jtrelawney/Seifenkiste_0/docu/images/car_full_1.jpg

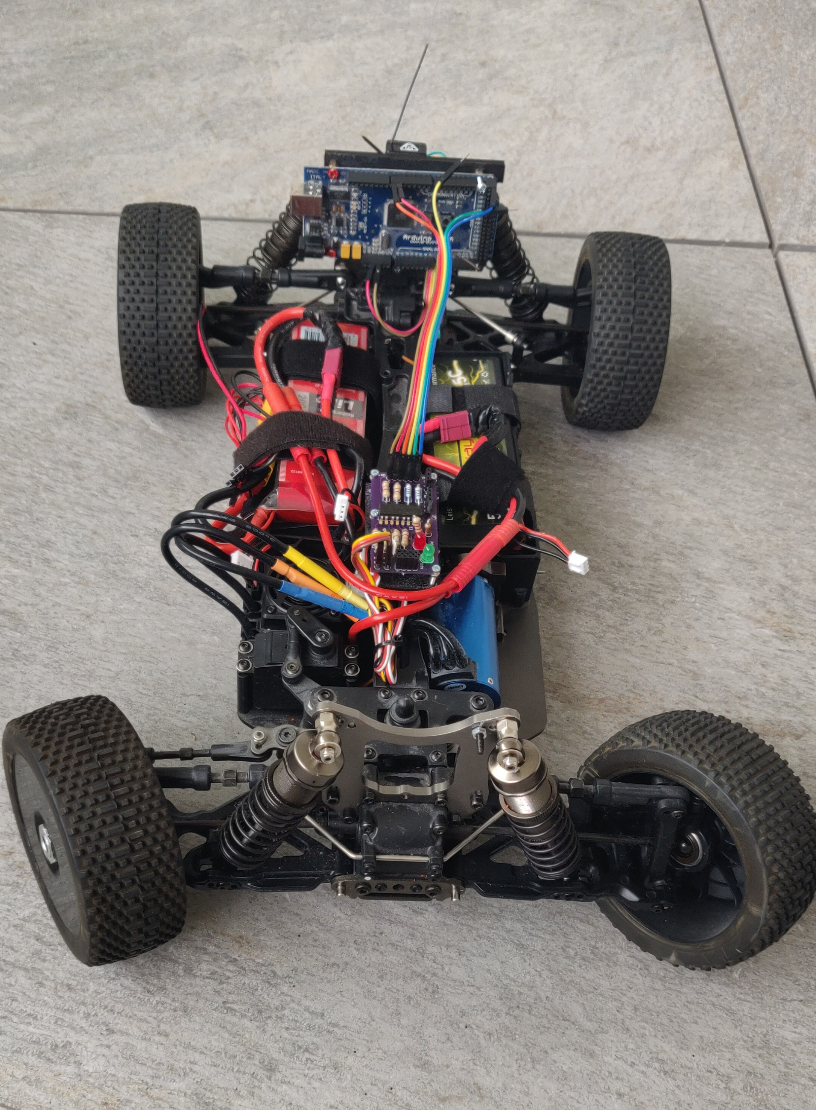
docu/images/car_full_1.jpg
