jtrelawney/Seifenkiste_0/docu/images/receiver_1.jpg

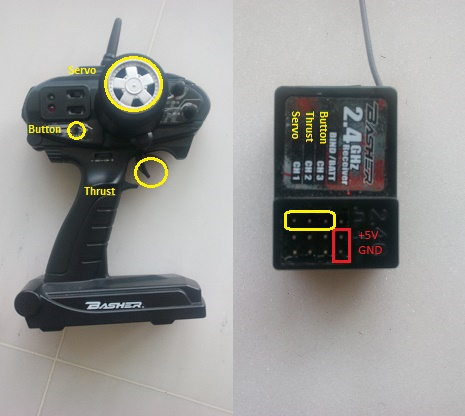
docu/images/receiver_1.jpg
