jtrelawney/Seifenkiste_0/README.md

# Seifenkiste_0
Hack the controller of a remote controlled car

V1 - read RC and set PWM
1. Port K interrupts read RC throttle and steering
2. the signals are scaled
3. the pwm output is set
