jtrelawney/Seifenkiste_0/controller_board/Receiver.odt

# Receiver

## Throttle

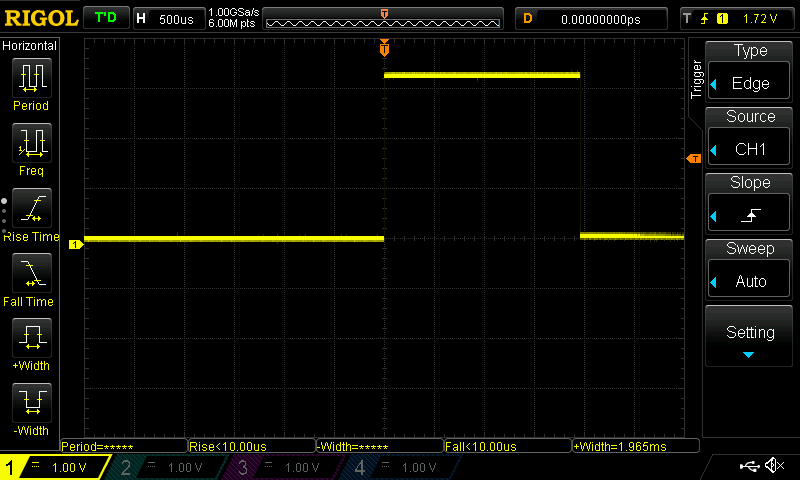
[picture p3: figure]
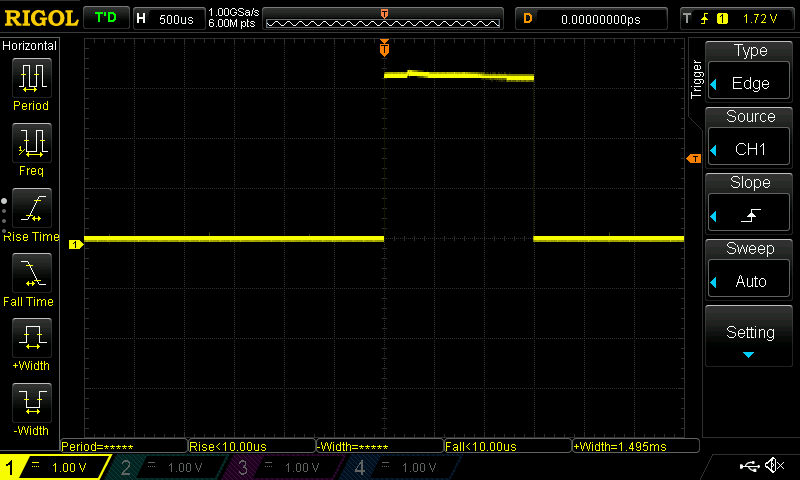
[picture p4: figure]
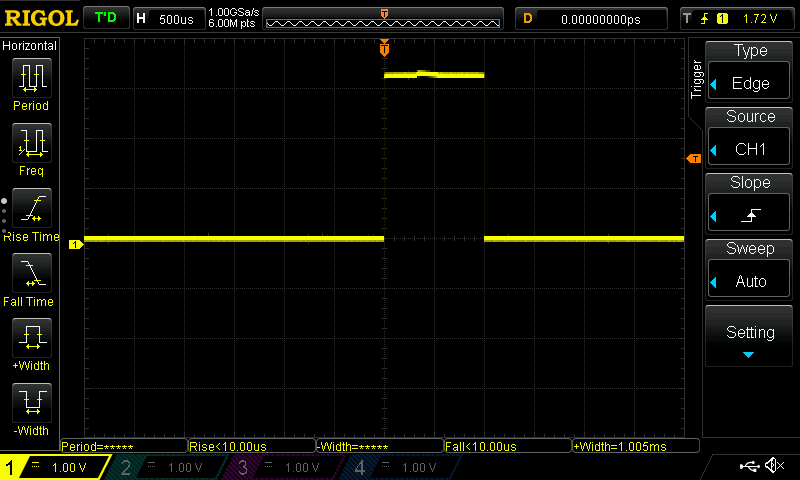
[picture p5: figure]

## Steering

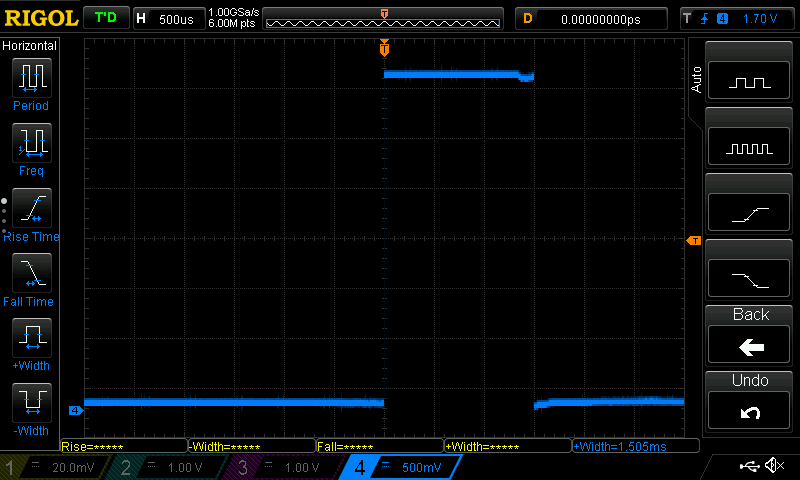
[picture p6: figure]
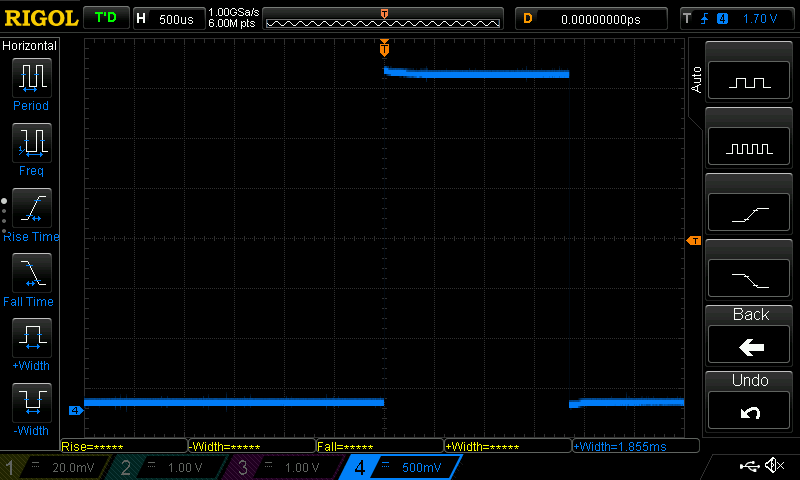
[picture p7: figure]
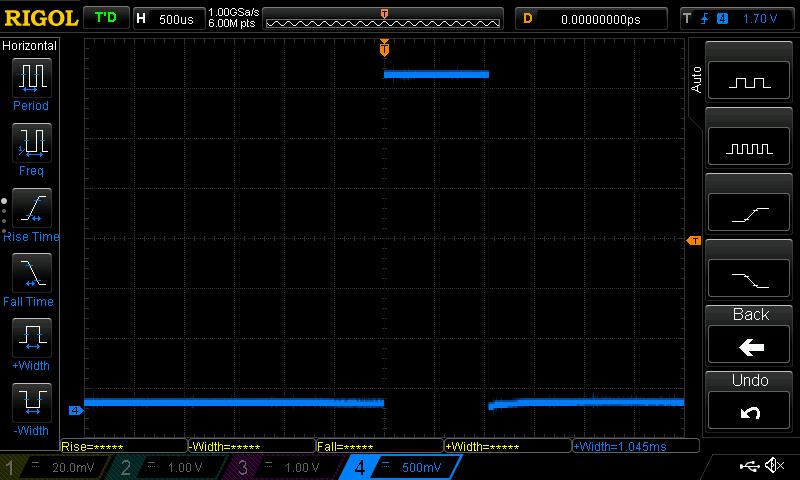
[picture p8: figure]

## Start button

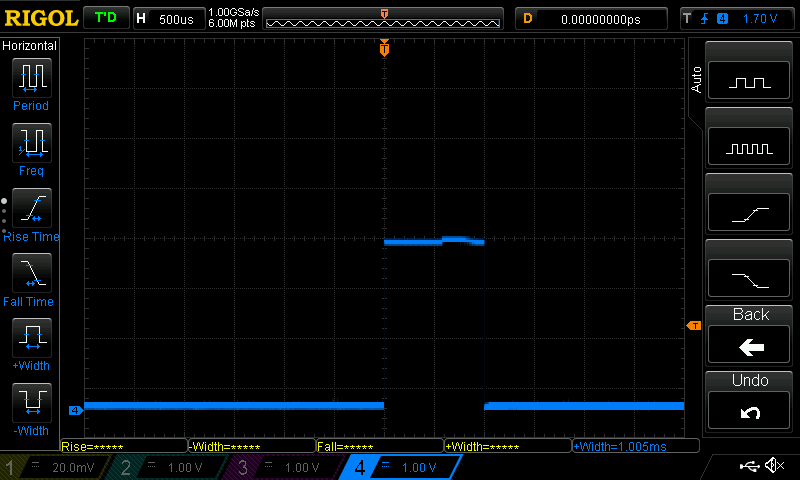
[picture p9: figure]
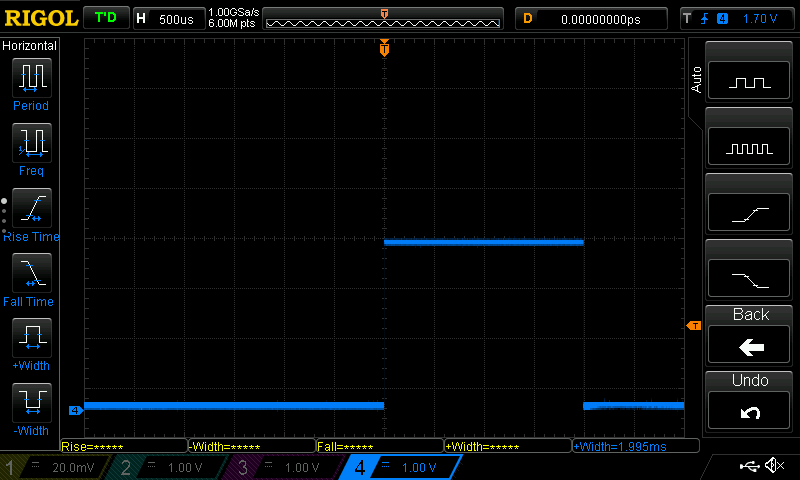
[picture p10: figure]
