jtrelawney/Seifenkiste_0/docu/ESC_programming.odt

To program the ESC : page 7-9 manual:

In general:

The green LED signals the item number, ie. if it flashes once this is the “running mode” entry.

The red LED signals the current items value, ie. if it flashes once this is “Forward with break”

Settings can be selected by releasing and pressing the SET button as described below

1. turn off ESC
2. turn on transmitter
3. hold set key and keep it pressed
4. switch on ESC

Keep holding down the SET button!

The Red LED flashes 8 or 9 times and the ESC enters the programmable mode.

Next the green LED flashes once.

This indicates that currently item number 1 “running mode” is selected.

To program item 1 release the SET key.

To program one of the next items keep the SET button pressed until the ESC has increased the item number and the green LED has flashed the corresponding number of times.

Once the item number is selected by releasing the SET button, the red LED indicates the items’s current value by flashing the corresponding number of times.

With short breaks the ESC will continue to indicate the currently selected items value.

To keep the current value switch off the ESC.

To increase the item’s value give the SET button a short push.

The ESC will now indicate the new value by flashing accordingly.

End the programming by switching off the ESC.

To calibrate the ESC with the RC signal range : page 6 manual:

1. turn off ESC
2. turn on RC with throttle in REV
3. press the SET key and turn on the ESC
4. as soon as the red light flashes release the SET key, the red light keeps flashing
5. the RC should be on neutral, i.e. the controller software should output 1.5ms
6. then press the SET key, there is one green light signal
7. the RC should now output the max forward signal, I.e the controller output needs to be 2ms.
8. Then press the SET key again, there are 2 green light signals
9. the RC should now output the max backward signal, I.e the controller output should be 1ms
10. press the SET key one last time, there are 3 green light signals.
11. Then turn of the ESC and wait 3s before turning on

The ESC is now calibrated to the range of the RC, or here to the range of the controller between 1ms and 2ms
