jtrelawney/Seifenkiste_0/controller_board/transmitter_battery/transmitter_battery.odt

Remote control battery

8 batteries which take in 2shifts of 4 take a full day to charge.

Use an LM317 together with a lipo battery to increase the time until recharge and allow for a faster charging process.

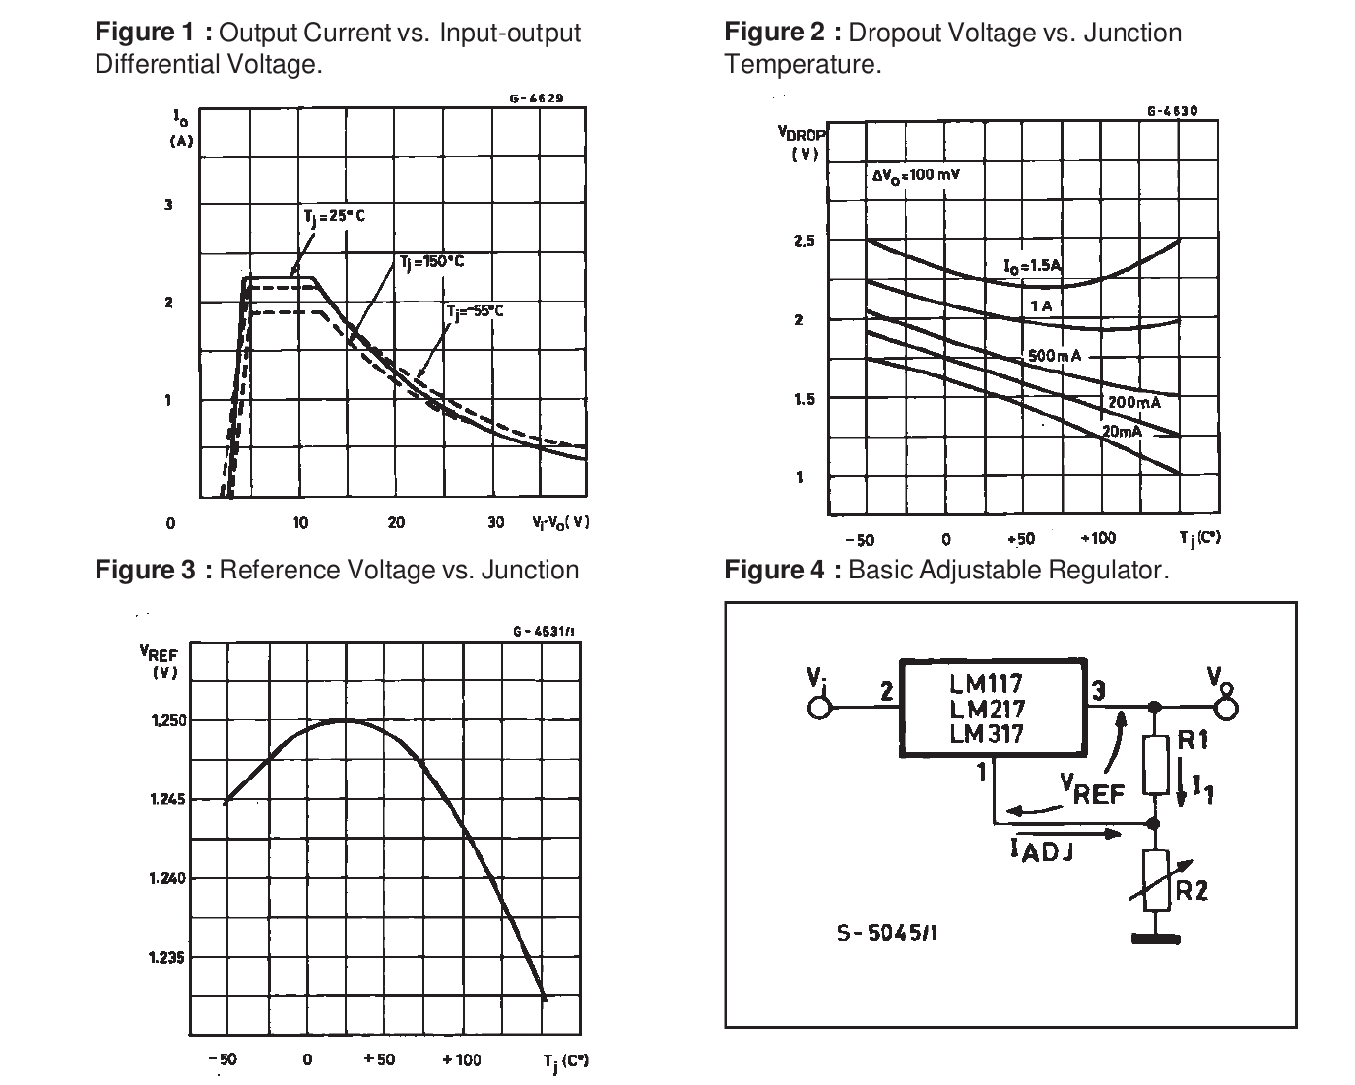
[picture p11: figure]
