jtrelawney/Seifenkiste_0/car_basher_truggy/ESC programming/programmable_settings.pdf

## BASHER SABERTOOTH MANUAL

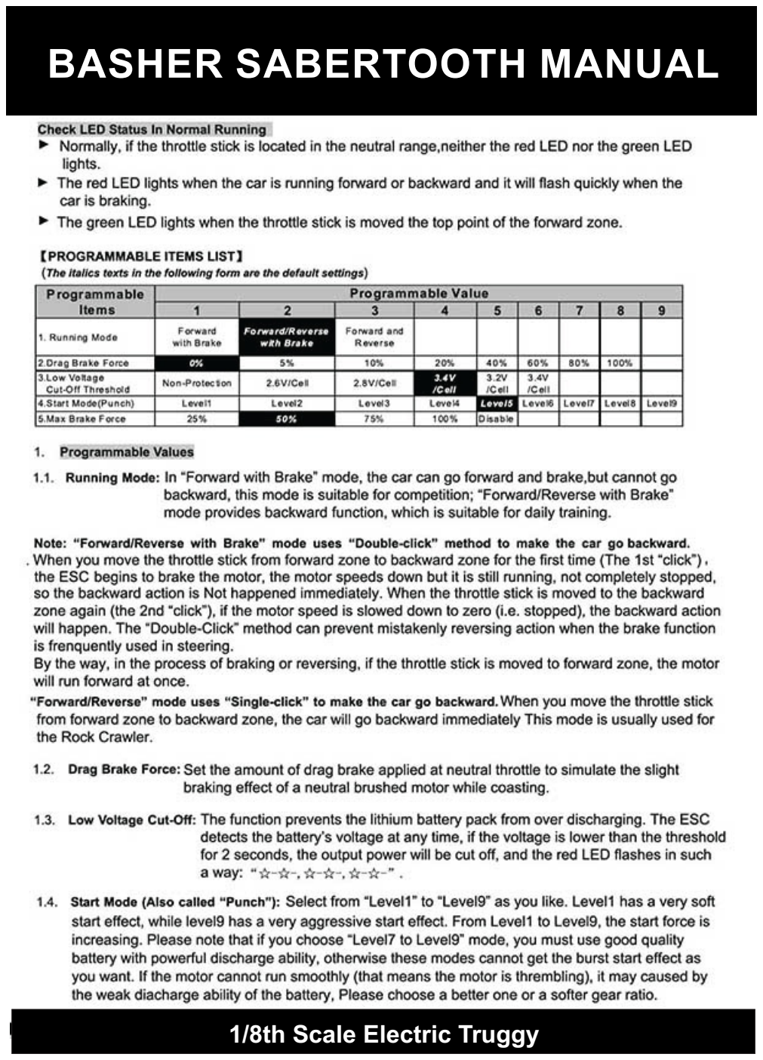
[picture p12: page 1]

1/8th Scale Electric Truggy
