jtrelawney/Seifenkiste_0/car_basher_truggy/3d_models/back_panel_2.png

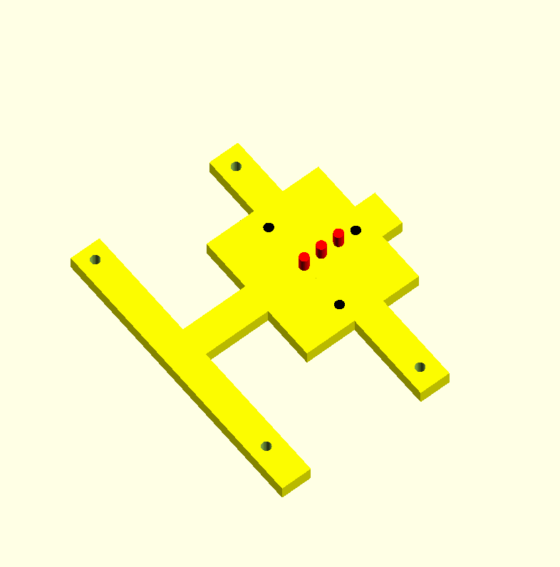
car_basher_truggy/3d_models/back_panel_2.png
