jtrelawney/Seifenkiste_0/car_basher_truggy/3d_models/controler_bed_1.png

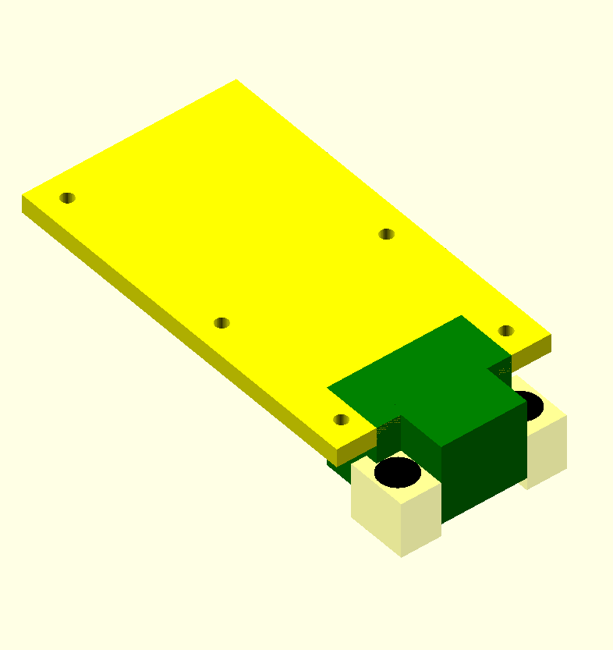
car_basher_truggy/3d_models/controler_bed_1.png
