jtrelawney/Seifenkiste_0/car_basher_truggy/ESC programming/programmable_settings_notes.jpg

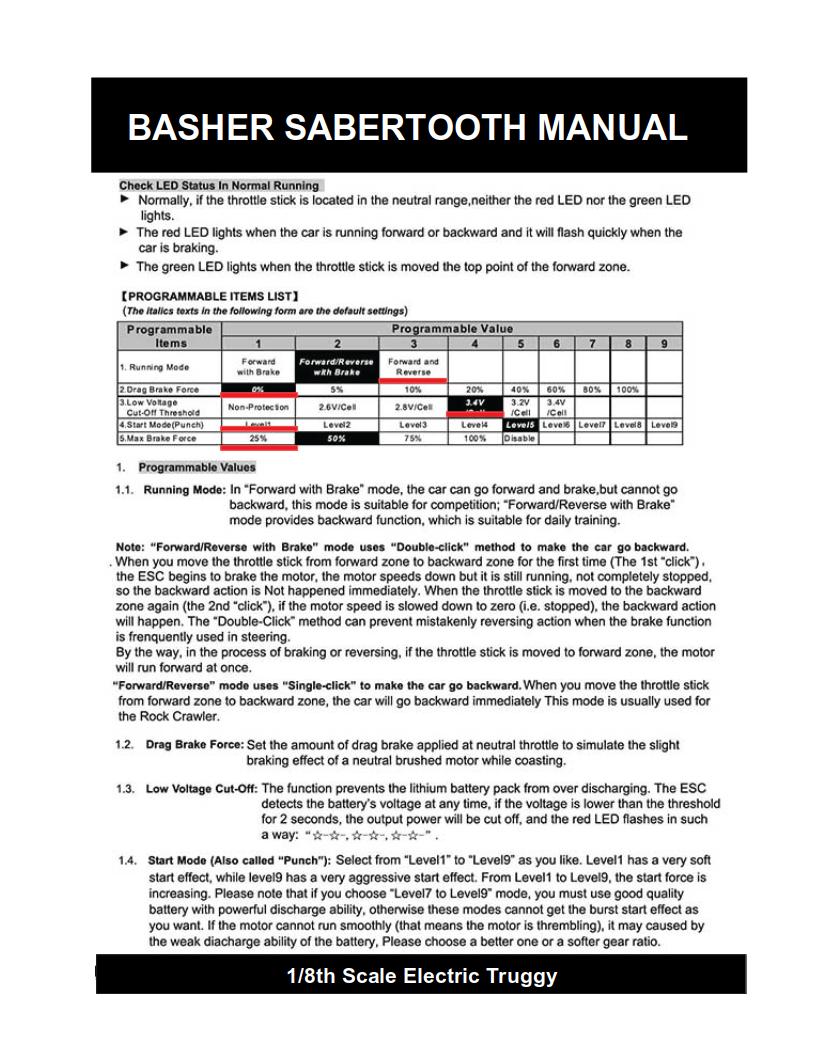
car_basher_truggy/ESC programming/programmable_settings_notes.jpg
