jtrelawney/Seifenkiste_0/controller_board/transmitter_battery/lm317_diodes.png

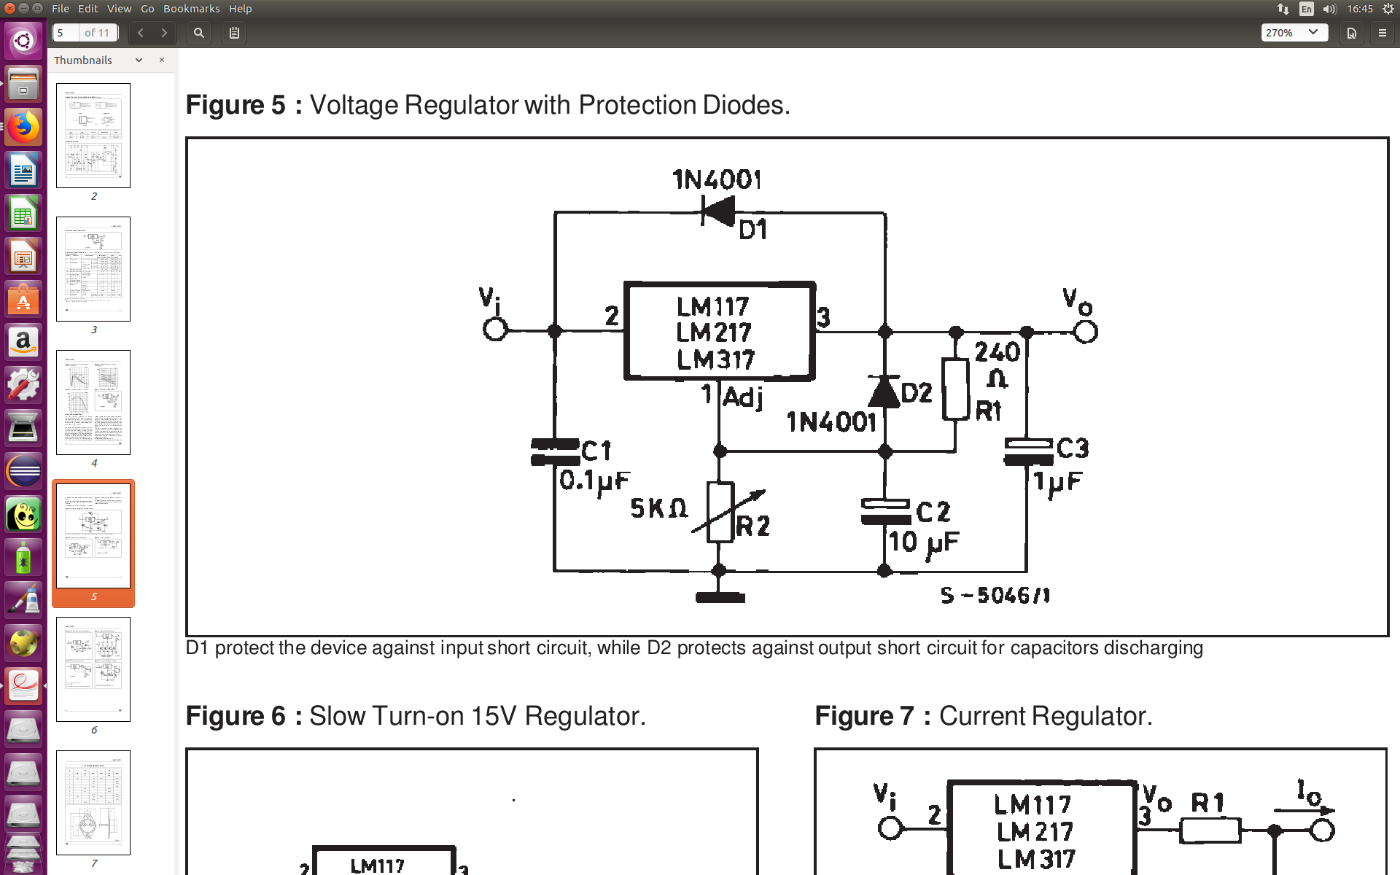
controller_board/transmitter_battery/lm317_diodes.png
