jtrelawney/Seifenkiste_0/docu/images/base_1500_4.png

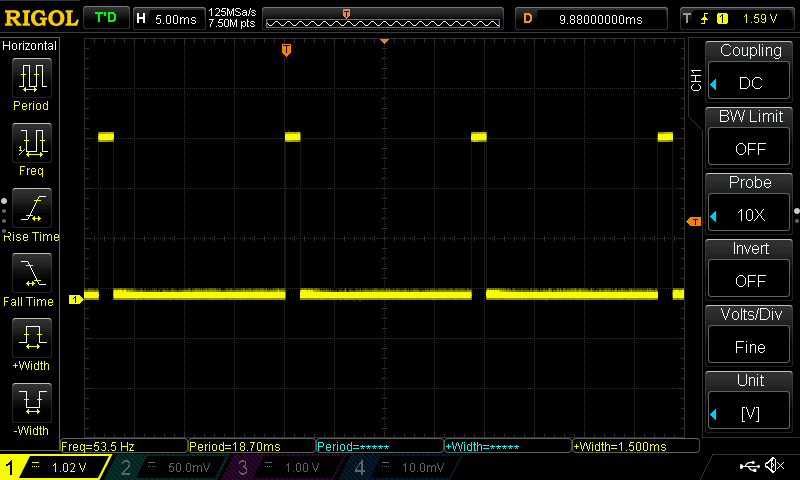
docu/images/base_1500_4.png
