jtrelawney/Seifenkiste_0/docu/images/differential_gearbox.jpg

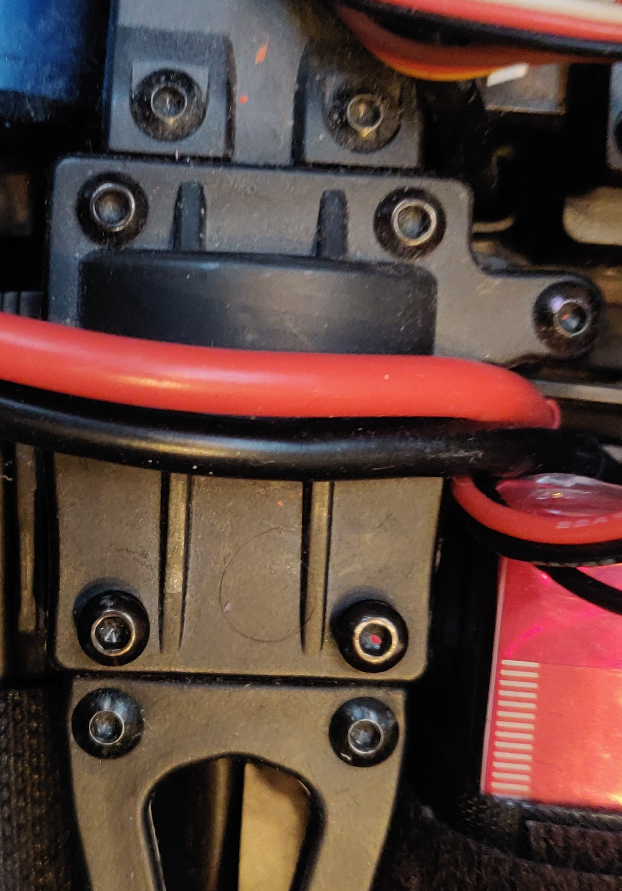
docu/images/differential_gearbox.jpg
