jtrelawney/Seifenkiste_0/docu/images/differential_gearbox_orig.jpg

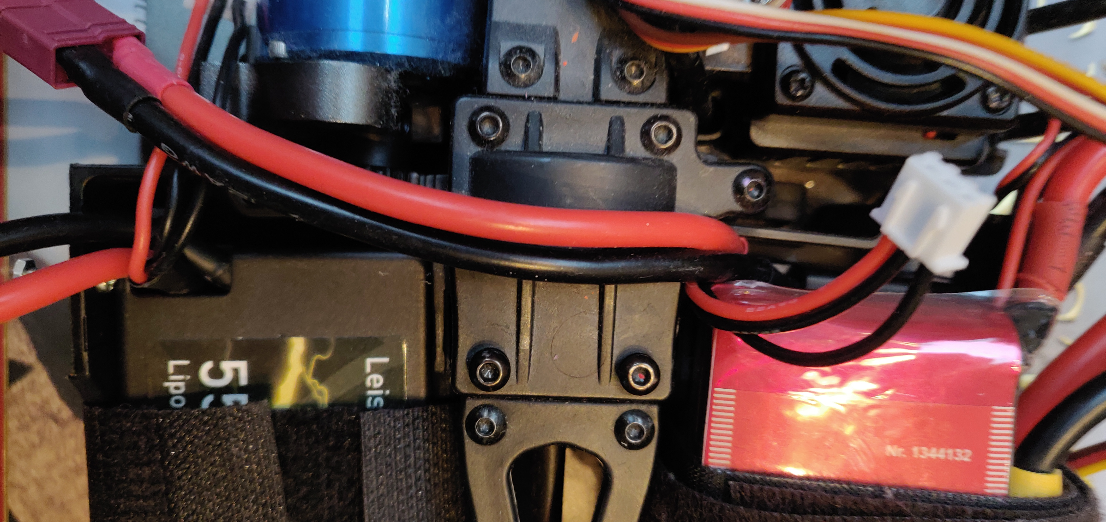
docu/images/differential_gearbox_orig.jpg
