jtrelawney/Seifenkiste_0/docu/images/lipo_remote.jpg

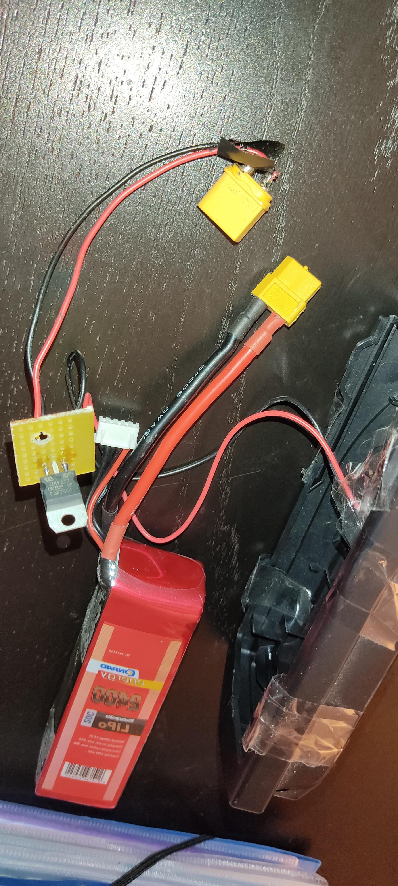
docu/images/lipo_remote.jpg
