jtrelawney/Seifenkiste_0/docu/images/max_1850_1.png

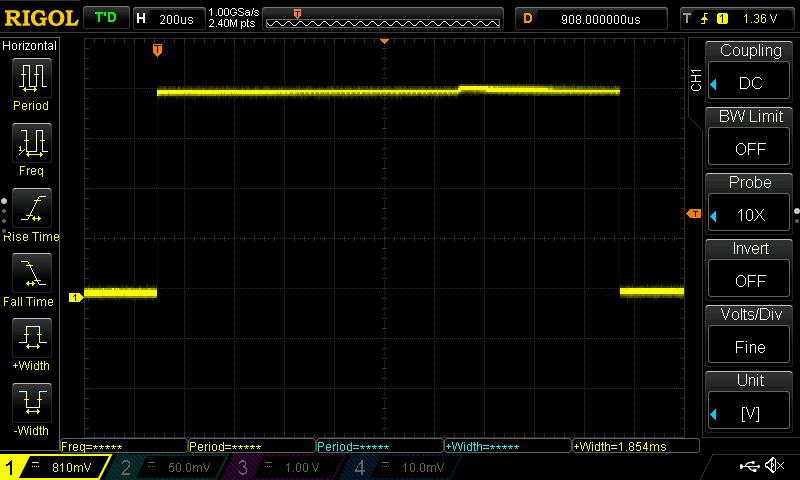
docu/images/max_1850_1.png
