jtrelawney/Seifenkiste_0/docu/images/min_1200_1.png

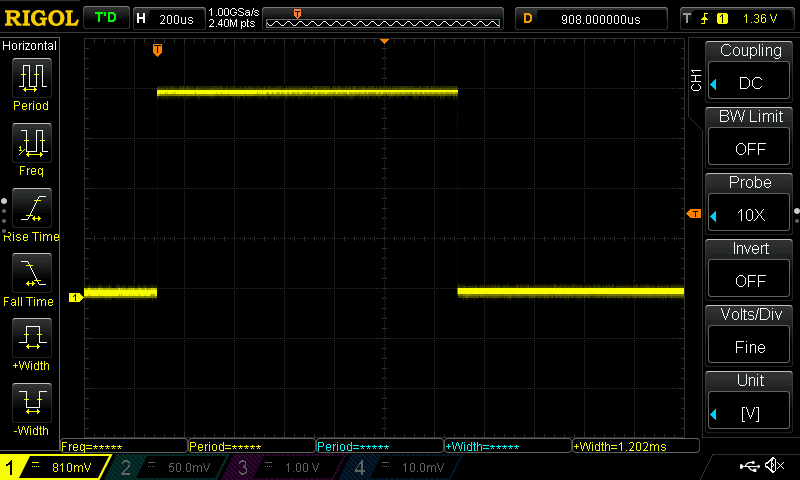
docu/images/min_1200_1.png
