jtrelawney/Seifenkiste_0/docu/images/motor_controller_processed.jpg

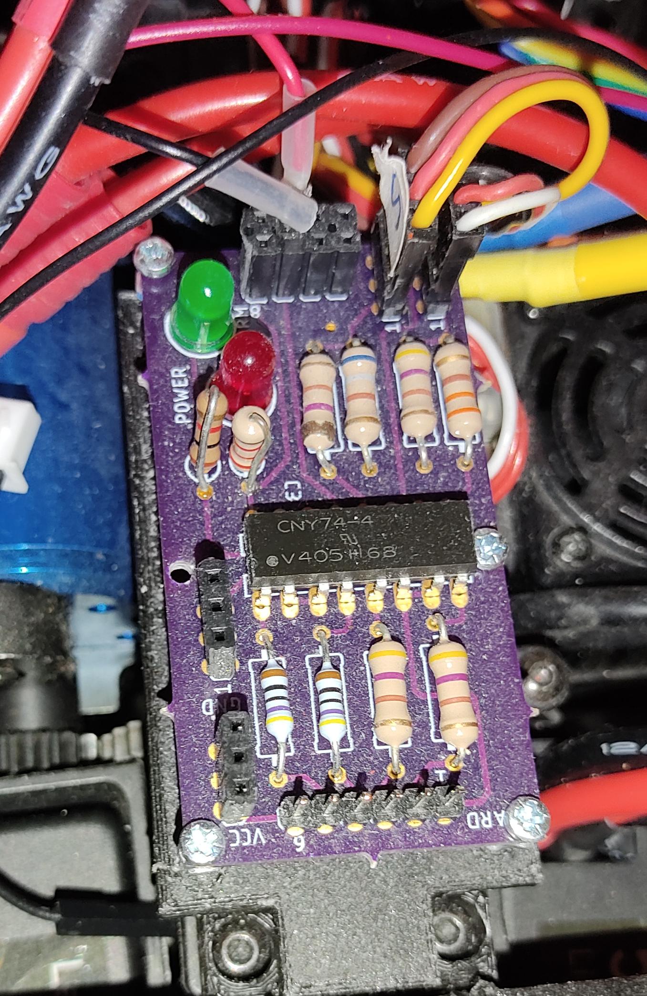
docu/images/motor_controller_processed.jpg
