jtrelawney/Seifenkiste_0/car_basher_truggy/3d_models/controler_bed_1.stl

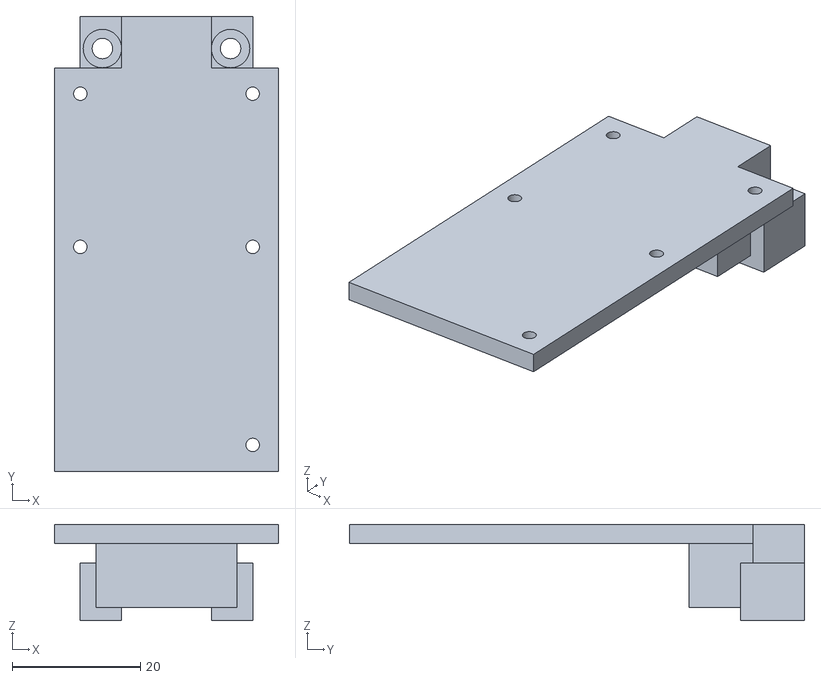
[picture p26: CAD file, 2019-12-01]
car_basher_truggy/3d_models/controler_bed_1.stl
35.0 x 71.0 x 15.0
