jtrelawney/Seifenkiste_0/car_basher_truggy/3d_models/back_panel_2.stl

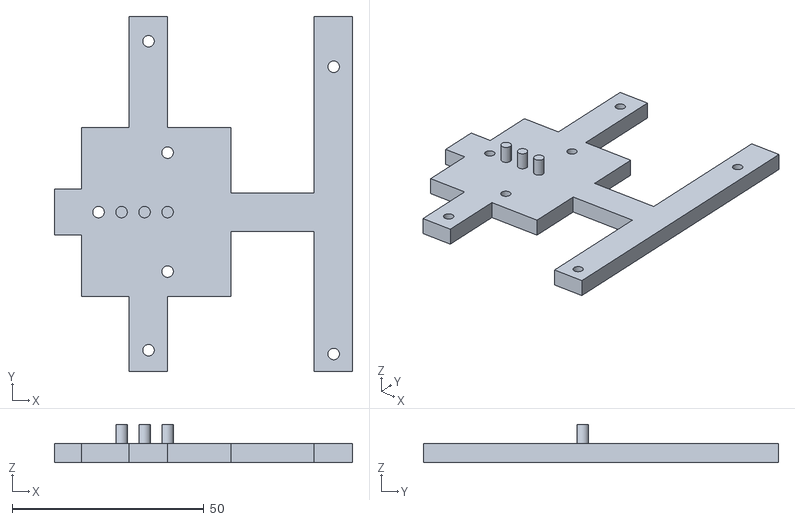
[picture p27: CAD file, 2019-12-01]
car_basher_truggy/3d_models/back_panel_2.stl
77.7 x 92.5 x 10.0
