jtrelawney/Seifenkiste_0/car_basher_truggy/3d_models/back_panel_1.stl

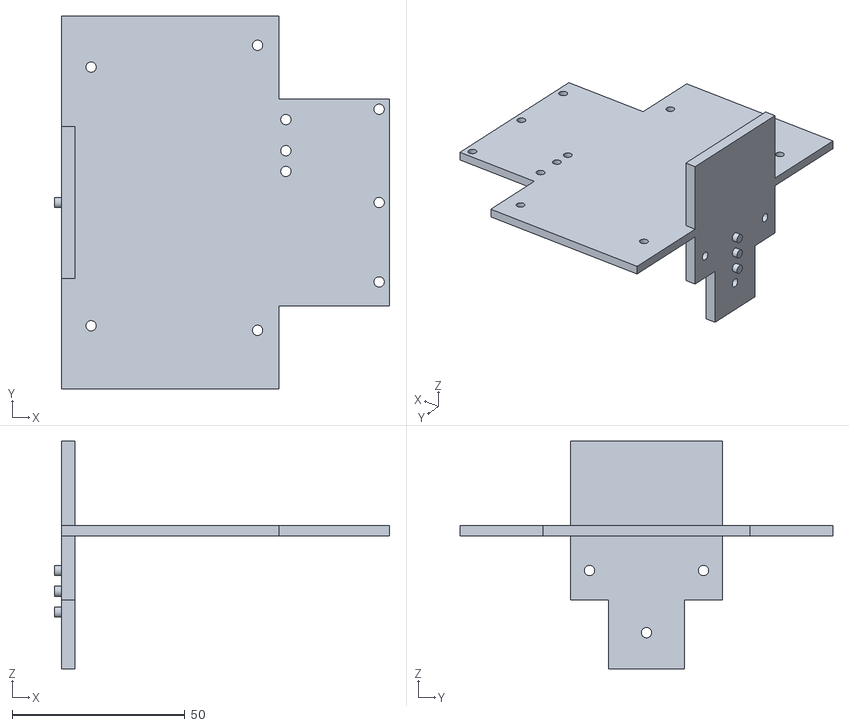
[picture p28: CAD file, 2019-12-01]
car_basher_truggy/3d_models/back_panel_1.stl
97.0 x 108.0 x 66.0
