jtrelawney/Seifenkiste_0/controller_board/making_cables.odt

1. Blank the cable
  - length so that the blank part into the middle area
  - it shouldn’t reach into the front part, that is where later the plug goes
  - the v-cramp should grip the plastic
2. prepare the shoe
  - pre-bend the v bracket
  - the cable should easily fit
  - the v should later fold together under crimp pressure and not open up
3. slide the cable into the shoe
  - plug stays empty
  - middle part is cable
  - top part plastic
4. crimp
  - with cable in shoe, the v should point to the outside (round part which bends the v)
  - do not squeeze the plug part, it needs to stay open to take in the plug
  - push tool together and if necessary make a couple more pushes, so that V grips cable
5. solder very slightly to make contact and fix the cable to the shoe
6. push into holder, ideally so that it clicks when the display window locks into the finger
