jtrelawney/Seifenkiste_0/controller_board/receiver_oszi_directly/DS1Z_QuickPrint1.png

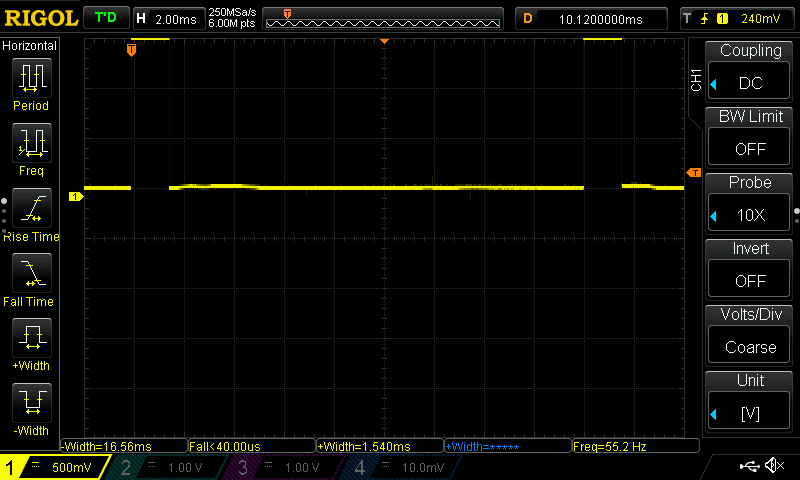
controller_board/receiver_oszi_directly/DS1Z_QuickPrint1.png
