jtrelawney/Seifenkiste_0/portkextint.h

#ifndef PORTKEXTINT_H_
#define PORTKEXTINT_H_

#include "Arduino.h"

// device declarations for indexing and accessing the related port
enum port_k_connected_device_types { throttle = 0, steering = 1, RC_calibration = 7 };

class scaler_class {
private:
	uint16_t neutral_epsilon = 20;	// consider delta around neutral as neutral
	uint16_t min_signal_in = 1000;
	uint16_t neutral_signal_in = 1500;
	uint16_t max_signal_in = 2000;
	uint16_t min_signal_out = 1000;
	uint16_t neutral_signal_out = 1500;
	uint16_t max_signal_out = 2000;
public:
	scaler_class(){};
	void set_input_range(const uint16_t min_in, const uint16_t max_in) {
		min_signal_in = min_in;
		max_signal_in = max_in;
	};
	void set_output_range(uint16_t min_out, uint16_t max_out) {
		min_signal_out = min_out;
		max_signal_out = max_out;
	};

	uint16_t calc_scaled_duty(uint16_t duty){
		uint16_t result=neutral_signal_in;
		float factor = 0.0;
		bool valid_high_signal = (duty>neutral_signal_in+neutral_epsilon);
		if (valid_high_signal) {
			if (duty>max_signal_in) duty = max_signal_in;
            int nom1 = (duty - neutral_signal_in);
		    int denom1 = (max_signal_in - neutral_signal_in);
            factor = (float)nom1 /(float)denom1;
            float range = (float)(max_signal_out) - (float)(neutral_signal_out);
		    float scaled = factor * range;
            result = (unsigned int) ( (float) neutral_signal_out + scaled );
		}
		bool valid_low_signal = (duty<neutral_signal_in-neutral_epsilon);
		if (valid_low_signal) {
			if (duty<min_signal_in) duty = min_signal_in;
            int nom1 = (duty - neutral_signal_in);
		    int denom1 = (min_signal_in - neutral_signal_in);
		    factor = (float)nom1 /(float)denom1;
            float range = (float)(min_signal_out) - (float)(neutral_signal_out);
		    float scaled = factor * range;
            result = (unsigned int) ( (float) neutral_signal_out + scaled );
		}
		/*
		  Serial.print("t = ");
		  Serial.print(millis());
		  Serial.print("   duty = ");
		  Serial.print(duty);
		  Serial.print("   factor = ");
		  Serial.print(factor);
		  Serial.print("   scaled = ");
		  Serial.println(result);
		*/
		return result;
	}
};

// the ISR for the PortK external interrupts calls these specific routines
// here port specific evaluations are executed and
// the related external processing routine is called
void port_k_throttle_ISR(uint8_t port_bitpattern);
void port_k_steering_ISR(uint8_t port_bitpattern);
void port_k_ISR(uint8_t port_bitpattern, port_k_connected_device_types device_port_no);

// management functions
void port_k_interrupt_off();
void port_k_interrupt_on();
void port_k_config();
void port_k_get_data(const port_k_connected_device_types port_no, unsigned long *signal_time_stamp, unsigned int *signal_duration, unsigned long *duty_time_stamp, unsigned int *duty_duration);

#endif /* PORTKEXTINT_H_ */
