jtrelawney/Seifenkiste_0/(commit log)

2019-09-18 V1 external interrupts read RC signal and sets scaled pwm output
2019-09-30 implemented receiver, pwm and calibration. collecting datasheets and manuals
2019-12-01 started Docu
    [back_panel_1.scad, back_panel_1.stl, back_panel_2.scad, back_panel_2.stl, controler_bed_1.scad, controler_bed_1.stl, some_calcs.ods]
